CROUZET/claudine-cube/docs/building_pictures/IMG-20260719-WA0002.jpeg

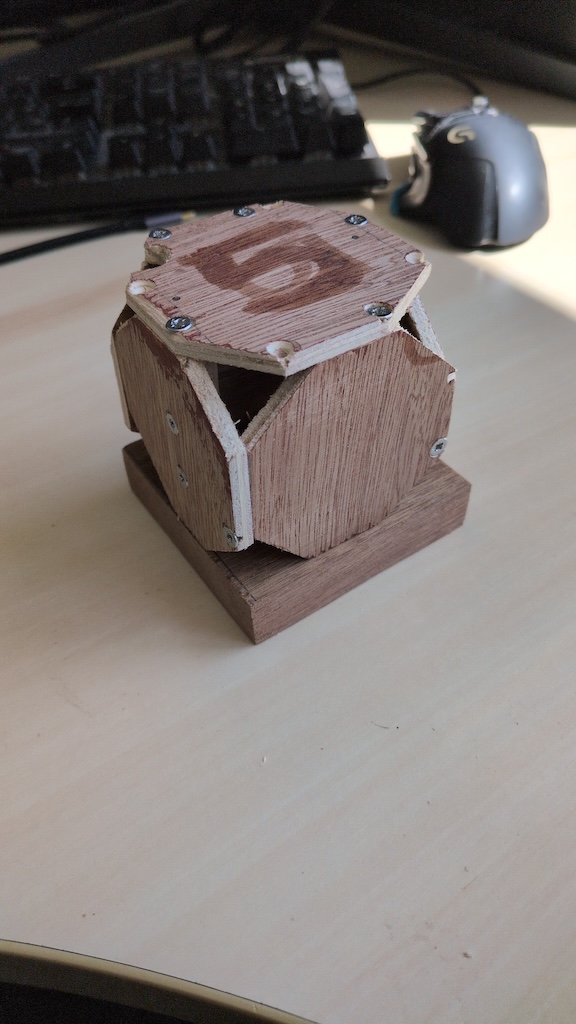
docs/building_pictures/IMG-20260719-WA0002.jpeg
