CROUZET/claudine-cube/docs/building_pictures/PXL_20260710_210710005.jpg

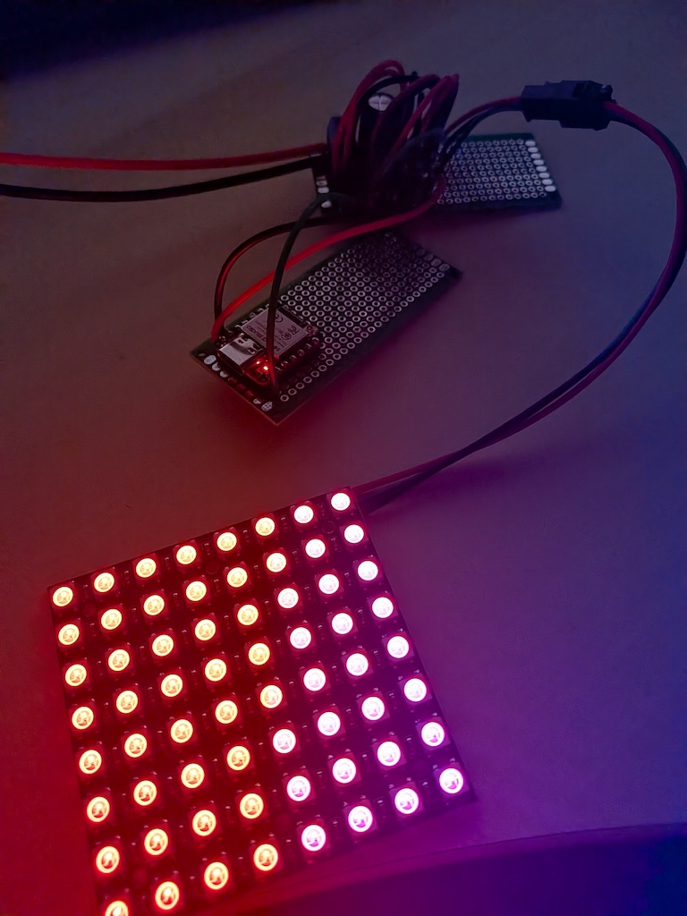
docs/building_pictures/PXL_20260710_210710005.jpg
