CROUZET/claudine-cube/docs/building_pictures/PXL_20260710_224117505.jpg

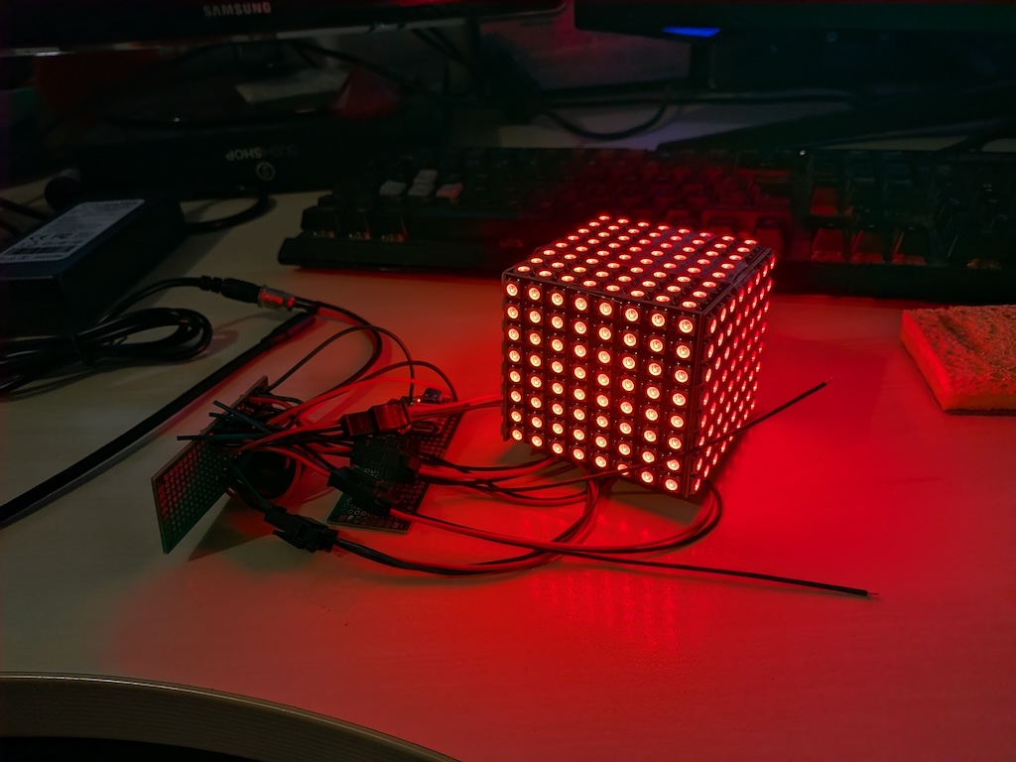
docs/building_pictures/PXL_20260710_224117505.jpg
