CROUZET/claudine-cube/docs/building_pictures/PXL_20260710_225541593.jpg

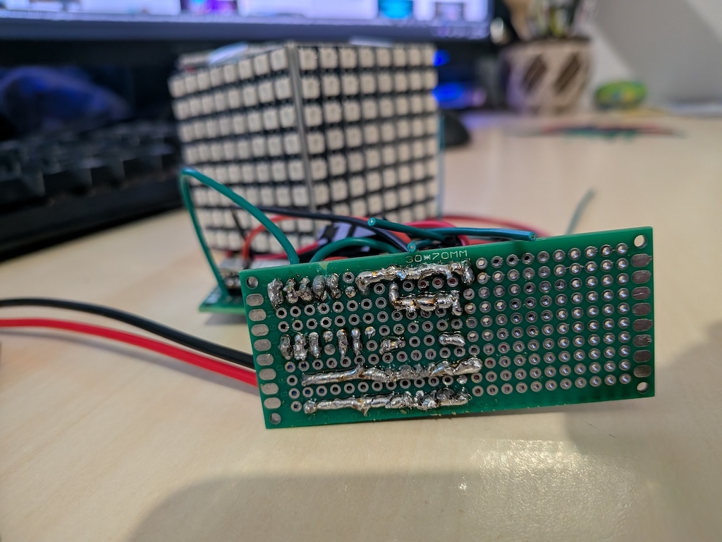
docs/building_pictures/PXL_20260710_225541593.jpg
