CROUZET/claudine-cube/docs/building_pictures/PXL_20260719_164101151.jpg

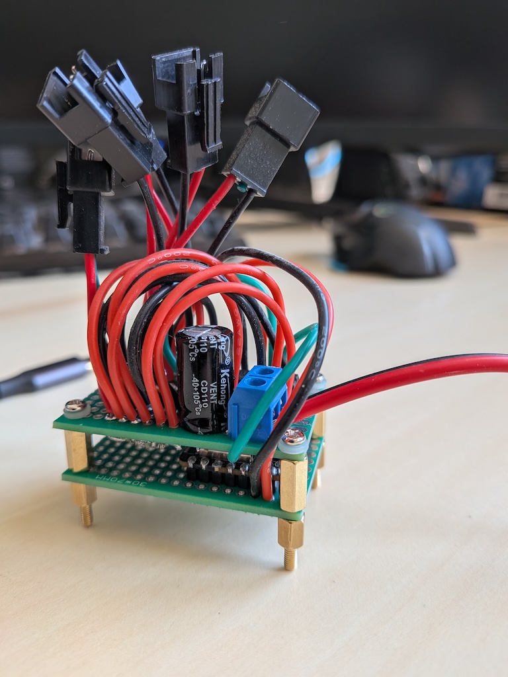
docs/building_pictures/PXL_20260719_164101151.jpg
