CROUZET/claudine-cube/docs/building_pictures/PXL_20260719_164112641.jpg

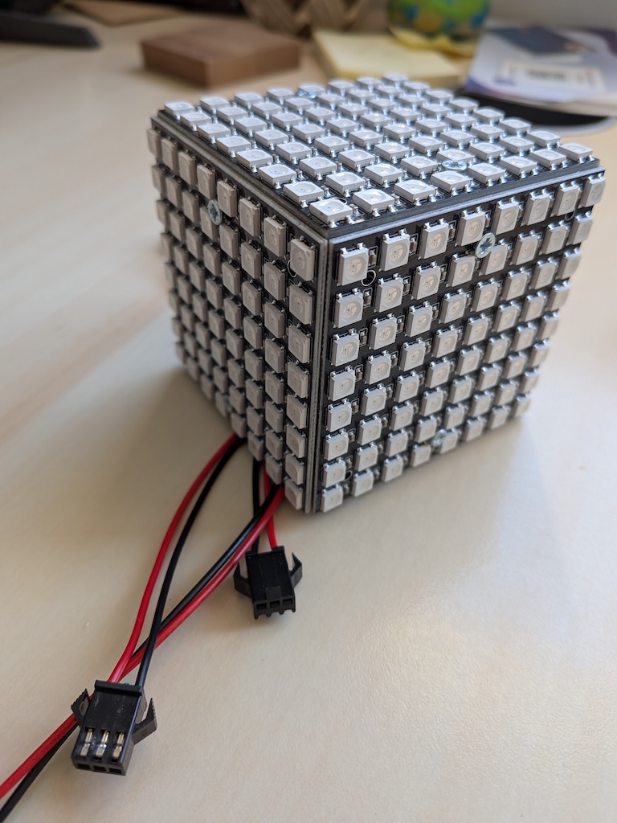
docs/building_pictures/PXL_20260719_164112641.jpg
