CROUZET/claudine-cube/docs/building_pictures/PXL_20260720_164136679.jpg

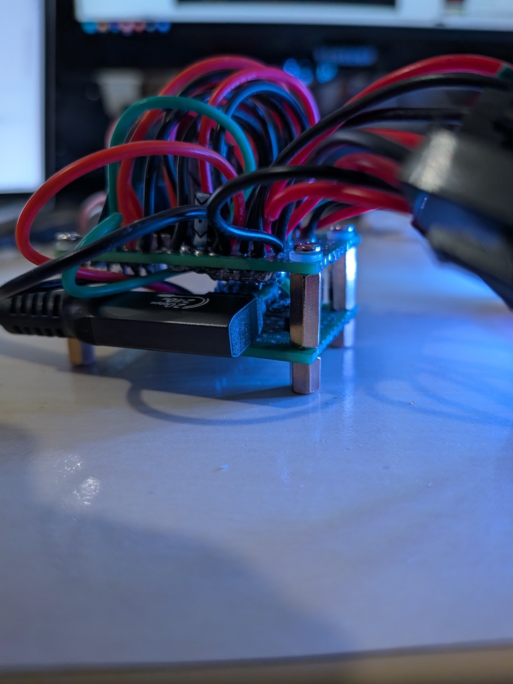
docs/building_pictures/PXL_20260720_164136679.jpg
