CROUZET/claudine-cube/docs/building_pictures/PXL_20260720_222201605.jpg

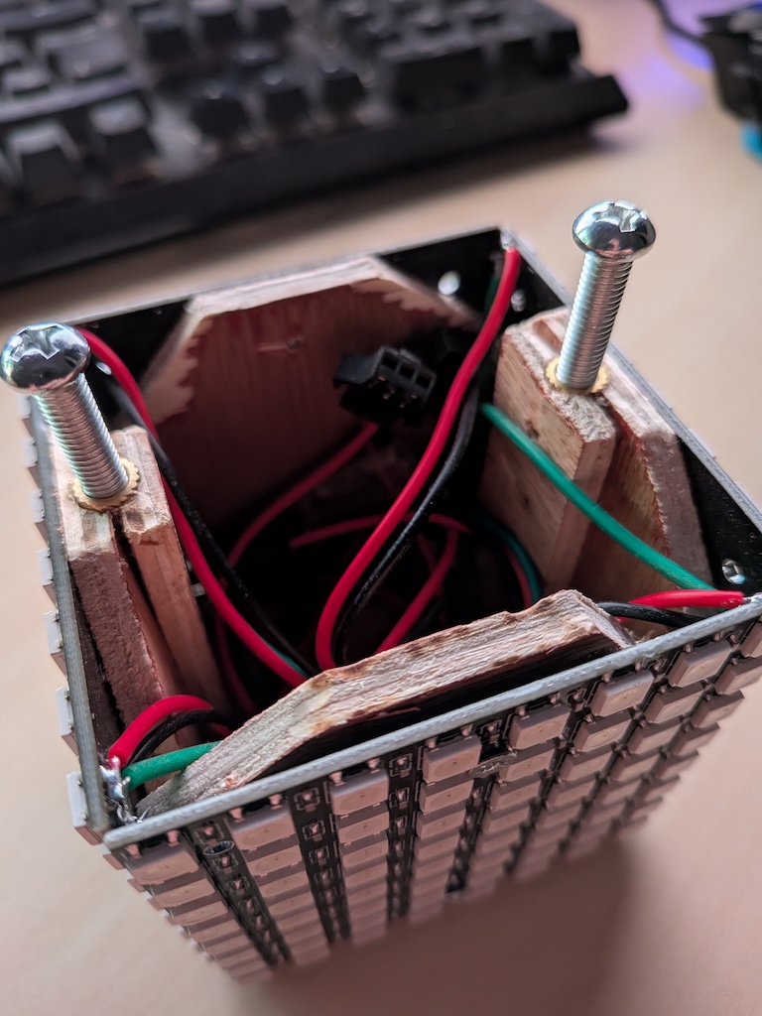
docs/building_pictures/PXL_20260720_222201605.jpg
