CROUZET/claudine-cube/docs/building_pictures/PXL_20260721_110255108.jpg

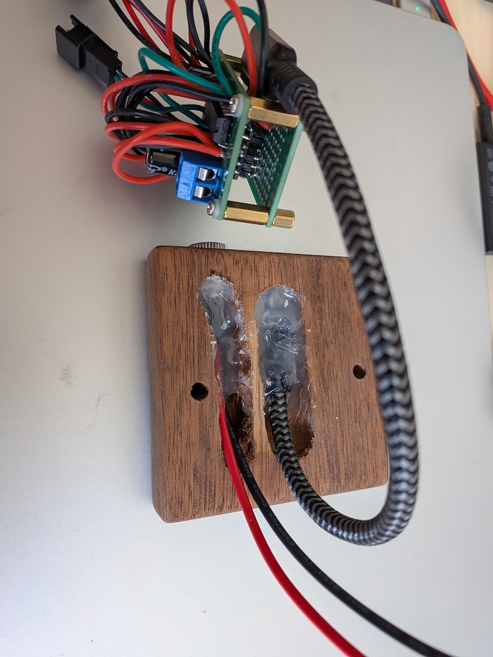
docs/building_pictures/PXL_20260721_110255108.jpg
