CROUZET/claudine-cube/docs/building_pictures/PXL_20260721_115038355.jpg

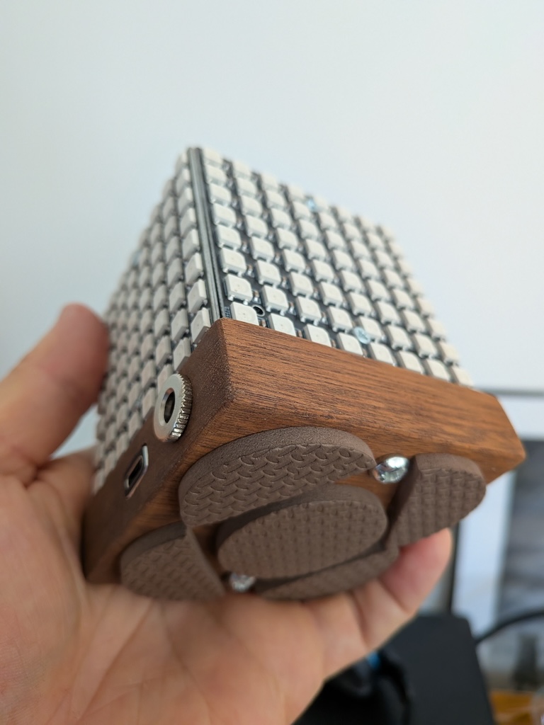
docs/building_pictures/PXL_20260721_115038355.jpg
