CROUZET/claudine-cube/docs/building_pictures/PXL_20260721_115052303.jpg

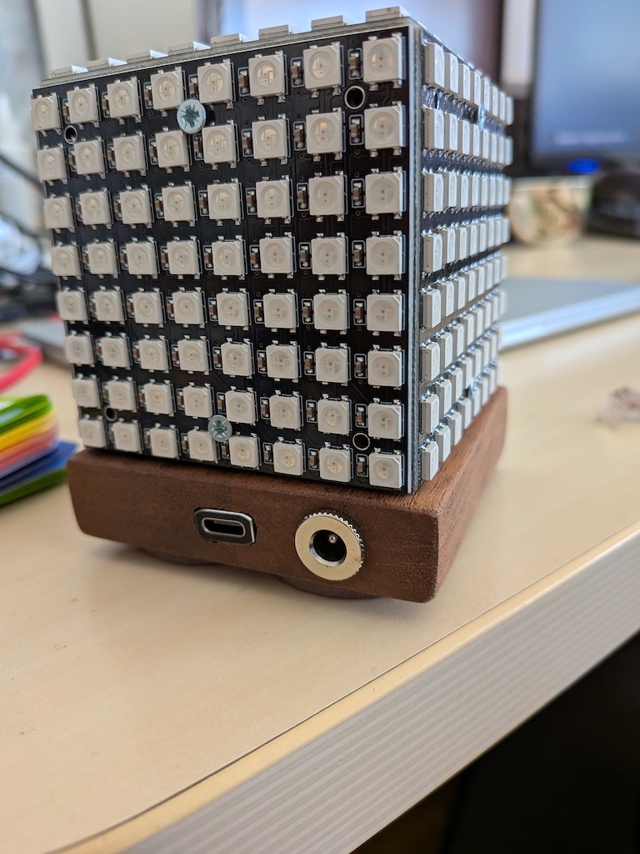
docs/building_pictures/PXL_20260721_115052303.jpg
