CROUZET/claudine-cube/sketch_firmware/testing/flashing_colors.ino

#include <FastLED.h>
#define DATA_PIN 1
#define NUM_LEDS 320
CRGB leds[NUM_LEDS];

void setup() {
  FastLED.addLeds<WS2812B, DATA_PIN, GRB>(leds, NUM_LEDS);
  FastLED.setBrightness(20); // ~0.08, faible
}

void loop() {
  fill_solid(leds, NUM_LEDS, CRGB::Red);
  FastLED.show();
  delay(500);
  fill_solid(leds, NUM_LEDS, CRGB::Green);
  FastLED.show();
  delay(500);
  fill_solid(leds, NUM_LEDS, CRGB::Blue);
  FastLED.show();
  delay(500);
}
