CROUZET/claudine-cube/(commit log)

2026-07-16 Import initial : Claudine Cube (portage cube LED de Claudine)
    Portage du panneau plat 16×16 de Claudine vers un cube 5 faces 8×8
    (320 WS2812B) piloté par un XIAO ESP32-S3.
    - Panel réécrit en adressage par face (face,x,y) via CubeMapping
    (plus de serpentine/FLIP) ; Settings 8×8×5=320.
    - Firmware sur Adafruit NeoPixel (backends FastLED non fiables sur
    XIAO S3 / IDF5) + Serial.setRxBufferSize(4096) — correctif de la
    corruption de trame liée au débordement du buffer RX pendant show().
    - Set d'animations "cube" par défaut : 16 hooks volumétriques, sans
    texte, chaque event distinguable par le mouvement (utilisateur
    légèrement daltonien).
    - AnimationManager en deux couches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
    [flashing_colors.ino, sketch_firmware.ino]
2026-07-17 Ajoute une variante user_prompt en sens inverse
    - user_prompt_2 : vague cyan ouverte centre du dessus → descente des faces
    (inverse de UserPrompt), tirée au sort avec l'originale à chaque event.
    - test_cube_preview joue désormais toutes les variantes d'un hook, pas
    seulement la première.
2026-07-17 Idle : comète chevron au bas du cube + fix durée du preview
    - system_idle : chevron « > » qui tourne au ras du bas des faces latérales
    (2 tours pleins garantis avant le fondu), suivi d'une comète de chevrons
    répétés en dégradé exponentiel (>>>>>).
    - test_cube_preview joue chaque anim pour sa propre DURATION si elle en
    déclare une (avant, system_idle était coupé à 2,5 s → arrêt vers la 3e face).
2026-07-17 Notification : 4 variantes en anneaux concentriques
    Remplace le clignotement plein cube par des combinaisons de cadres
    carrés concentriques (face_ring), tirées au sort par le manager :
    - Notification : d=0 + d=2 (cible)
    - Notification2 : d=2 + d=3 (cœur)
    - Notification3 : d=0 + d=1 (cadre extérieur)
    - Notification4 : d=1 + d=3 (négatif de Notification)
2026-07-17 Session start/end : vague arc-en-ciel diagonale (chaud/froid)
    session_start balaie tout le volume en diagonale (montée puis reflux
    jusqu'à extinction) en couleurs chaudes ; session_end reprend le même
    geste en couleurs froides. Plage de teintes portée par HUE0/HUE1,
    surchargée par la sous-classe SessionEnd.
2026-07-17 Harmonise MIN_DURATION explicite + fix test flaky
    Ajoute un MIN_DURATION explicite aux 4 hooks qui tombaient sur le défaut :
    post_tool (=DUR 0.5), pre_tool (0.6), subagent_start (0.6), stop (1.0,
    aligné sur stop_failure).
    test_manager_states : accepte toute variante de la famille user_prompt
    (le manager en tire une au hasard) — le test était flaky (~1 run/4)
    car il comparait la classe exacte.
2026-07-17 pre_tool : serpent jaune/ambré qui navigue à travers le cube
    Remplace la colonne rotative par un serpent de 2 px de large suivant un
    parcours à travers les 5 faces (avant↑ → dessus → arrière↓ → virage vers
    la droite → face droite → remonte → dessus → gauche↓ puis disparaît).
    Piste précalculée (rungs), longueur BODY=18, teinte orange/ambré tête→queue,
    trajet décalé d'1 px à gauche et virages 1 px après le milieu. MIN_DURATION
    couvre tout le parcours.
2026-07-17 post_tool : couronne de créneaux tournante + fix test manager
    Remplace le flash par une couronne crénelée (merlons de rempart) à la base
    des 4 faces latérales, qui tourne autour du cube, dans l'orange/ambré du
    serpent (pre_tool).
    test_manager_states : dérive les instants du scénario des MIN_DURATION
    réelles des overlays (au lieu de temps codés en dur) — le test était cassé
    depuis l'allongement de pre_tool (serpent, 2.2s).
2026-07-17 system_idle : anneau équatorial clignotant puis extinction douce
    Remplace la comète de chevrons par un anneau de 2 px à l'équateur (rangées
    3,4 des 4 faces latérales) qui clignote doucement (pulsation cosinus) puis
    s'éteint en fondu monotone. Le clignotement creste pile au début du fondu
    (raccord à dérivée nulle) → extinction sans sursaut.
2026-07-17 stop : dissolution jaune par paliers de teinte
    Remplace la respiration bleue par un cube moucheté de SHADES teintes de
    jaune (clair → foncé, réparties au hasard) qui s'éteignent teinte par teinte
    à intervalle régulier (STEP), du clair au foncé, jusqu'à extinction complète.
    MIN_DURATION couvre toute la dissolution.
2026-07-17 task_done : reprend le geste de task_new en jaune
    task_done devient une sous-classe de task_new (même clignotement concentrique
    alterné) avec COLOR jaune. task_new lit self.class::COLOR pour permettre la
    surcharge.
2026-07-17 pre_compact/post_compact : damier 2×2 clignotant (gris / jaune)
    pre_compact devient un damier de carrés 2×2 qui s'inverse à intervalle
    régulier sur les 5 faces (gris). post_compact reprend le même geste en jaune
    via une sous-classe ; pre_compact lit self.class::COLOR pour la surcharge.
2026-07-17 tests : supprime chain/solid (bug résolu), refait edge sur les 8 arêtes
    test_cube_chain.rb et test_cube_solid.rb servaient à diagnostiquer le bug
    d'affichage dont la cause racine (buffer RX USB-CDC) est trouvée : supprimés.
    test_cube_edge.rb : au lieu de la seule arête avant→dessus, allume les 8
    arêtes partagées (pixels 2→6 des 2 côtés, une couleur par arête) pour
    vérifier/caler la continuité de toutes en un coup.
    Docs (CLAUDE.md, README.md, docs/SOFTWARE.md) mises à jour.
2026-07-17 CLAUDE.md : les 8 arêtes validées sur matériel
    test_cube_edge.rb (8 arêtes, 2 côtés) confirme sur le cube que les 3 arêtes
    dessus↔latérales restantes (droite/arrière/gauche→dessus) sont continues et
    alignées telles quelles, aucun offset. Les effets qui les traversent
    (top_edge_px, serpent de pre_tool) sont corrects.
2026-07-17 bunny/user_prompt : lapins sautillant + surcharge CLAUDINE_BRIGHTNESS
    user_prompt (fond « thinking » du set bunny) : des lapins bleu clair
    sautillent en file autour de l'anneau, à des hauteurs de saut variées ;
    aux grands sauts la tête déborde sur le dessus le long de l'arête franchie.
    Boucle sans raccord.
    Settings::BRIGHTNESS devient surchargeable via CLAUDINE_BRIGHTNESS (défaut
    0,08 inchangé) pour tester des niveaux de luminosité sans rien committer.
    Docs (CLAUDE.md, README.md, docs/SOFTWARE.md) mises à jour : set bunny en
    cours + nouvelle variable d'environnement.
2026-07-17 bunny/pre_tool : lapins qui sautent puis dansent sur les 4 faces + dessus
    Overlay « avant outil » du set bunny : un lapin traverse l'avant (1) en
    sautant gauche→droite→gauche puis danse (léger déhanché écrasé) ; arrière (3)
    en miroir ; droite (2) + gauche (4) jouent la même animation inversée dans le
    temps (danse puis sauts), 4 en miroir de 2. Sur le dessus, 8 pixels près des
    coins clignotent en rythme. Blanc bleuté (charte : début = clair).
2026-07-17 bunny/post_tool : lapins qui dansent + coins du dessus, fondu (jaune)
    Overlay « après outil » du set bunny : un lapin sur chacune des 4 faces
    latérales se déhanche (danses staggerées), le dessus reprend les 8 pixels de
    coin clignotants de pre_tool, et tout s'éteint en fondu du début à la fin.
    Jaune (charte : fin = jaune).
2026-07-17 bunny/post_tool_fail + stop_failure : lapin rouge tremblant + gros X
    Échec (outil ou fin de tour) : un lapin tremble de colère sur les 4 faces
    latérales, en rouge, et un gros X rouge épais clignote sur le dessus.
    Animation partagée : stop_failure sous-classe post_tool_fail.
    Charte : erreur = rouge.
2026-07-17 bunny/stop : lapins qui courent puis s'arrêtent de face (jaune, fade out)
    Fin de tour (succès) : les lapins courent autour du cube (façon user_prompt,
    en jaune) puis s'arrêtent et se tournent de face (petit lapin frontal centré
    sur chaque face latérale) avant de s'éteindre en fondu. DURATION exposée pour
    que l'aperçu joue toute la séquence.
2026-07-17 bunny/notification : lapin qui salue + carotte + anneau tournant
    Notification du set bunny : avant/arrière → gros plan d'une tête de lapin qui
    fait coucou de la patte (jaune) ; droite/gauche → gros plan d'une carotte
    (corps rouge + fanes vertes) qui rebondit ; dessus → anneau extérieur (2 px)
    d'arcs jaunes qui tournent.
2026-07-17 bunny/subagent_start : lapins qui jaillissent puis tournent en sautant
    Démarrage d'un sous-agent : un petit lapin surgit du bas (effet ressort) sur
    chacune des 4 faces latérales, puis les 4 lapins font le tour du cube en
    sautant vers la droite, chacun à la place du suivant, 4 fois (tour complet).
    Bleu clair (charte : début = clair).
2026-07-17 bunny/subagent_stop : lapins qui tournent puis plongent au terrier (jaune)
    Fin d'un sous-agent : même geste que subagent_start mais en jaune et dans
    l'ordre inverse — les 4 lapins font d'abord le tour du cube en sautant
    (4 sauts vers la droite) puis plongent dans leur terrier (pop vers le bas).
    Sous-classe de SubagentStart ; subagent_start lit self.class::COLOR.
    Charte : fin = jaune.
2026-07-17 bunny/system_idle : lapins endormis + bulles de sommeil vers le dessus
    Veille : sur les 4 faces latérales, un lapin en « loaf » (oreilles repliées)
    dort en respirant, avec des bulles qui remontent en zigzag, débordent sur le
    dessus (top_edge_px) et convergent vers le haut, puis tout s'éteint en fondu.
    DURATION exposée pour que le manager coupe le cube à la fin.
2026-07-17 bunny/task_new : grand lapin de profil qui marche autour du cube (bleu clair)
    Nouvelle tâche : un lapin en gros plan (profil) marche tranquillement autour
    de l'anneau des 4 faces latérales, avec un cycle de pattes, traversant les
    arêtes sans couture. Bleu clair (charte : début = clair).
2026-07-17 bunny/task_done : le lapin fait demi-tour et laisse une crotte (jaune)
    Tâche terminée : le même lapin que task_new (gros plan de profil) marche en
    jaune sur un demi-tour du cube, en laissant un petit caca brun à sa position
    de départ (révélé quand il s'éloigne), puis tout s'éteint en fondu. Sous-classe
    de TaskNew. Charte : fin = jaune.
2026-07-17 bunny/pre_compact : 4 têtes qui fusionnent en un lapin (bleu clair)
    Avant compaction : une tête de lapin monte sur chacune des 4 faces latérales,
    passe sur le dessus, converge vers le centre, et les 4 fusionnent en un
    nouveau lapin (le profil de user_prompt) qui éclot. Bleu clair (charte :
    début = clair).
2026-07-17 bunny/post_compact : lapin fusionné jaune clignotant sur les 5 faces — set complet
    Après compaction : le lapin fusionné de pre_compact (profil de user_prompt)
    apparaît identique sur les 5 faces, clignote en jaune et s'estompe.
    Dernier hook du set bunny → set complet (16 hooks). Docs (CLAUDE.md,
    README.md, docs/SOFTWARE.md) mises à jour : bunny n'est plus « en cours ».
2026-07-21 test: ajoute test de limite d'affichage (320 LEDs, montée en luminosité)
    test/test_cube_stress.rb pousse toutes les LEDs par paliers de luminosité
    en contournant le scaling du Panel. Mesures consignées :
    - jack DC : blanc plein 100% OK, aucun artefact (~19 A théo. très pessimiste)
    - USB seul : brownout entre 20-25% de blanc plein
    Limite pratique = thermique, pas l'intégrité d'affichage. Résultats aussi
    notés dans docs/HARDWARE.md.
2026-07-21 docs: add design docs, consolidate ideas, translate everything to English
    New design docs (design exploration / frozen spec, nothing built yet):
    - docs/INTENTIONS.md: intention vocabulary (V1 frozen) decoupling the cube
    from Claude Code — animations target neutral states, a profile maps hooks.
    - docs/MARKETPLACE.md: vision for a shareable-animation marketplace (safe
    third-party code execution via WASM, creator journey).
    - docs/IDEAS.md: single index of evolutions, organized by maturity.
    Consolidation: the three divergent "Future ideas" sections (README, SOFTWARE.md)
    now point to IDEAS.md; obsolete/reversed items reclassified (edge calibration
    already done, simulator-first reversed, de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
2026-07-21 feat: implement the intention layer (source ↔ rendering decoupling)
    Animations are now indexed by *intention* (neutral state verbs), not by
    Claude Code hook. Implements docs/INTENTIONS.md (V1, now 16 intentions —
    added handle/handled so the task level is distinct from the tool level).
    - lib/intentions.rb: the vocabulary (kind + fallback per intention, mandatory
    core, cycle-safe fallback resolution).
    - lib/profiles/claude_code.rb: data table mapping the 16 hooks 1:1 to intentions.
    - AnimationManager: registry keyed by intention; resolves event → intention via
    the profile, walks the fallback chain when a set lacks one; the temporal role
    comes from Intentions.kind (ambient/pulse/bo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
2026-07-21 firmware: one-shot boot sweep (powered & ready indicator)
    On power-up the firmware plays a short, dim rainbow that fills along the LED
    chain then goes dark — a self-contained "cube is powered and ready" signal
    (also a quick R/G/B self-test), with no app required. It plays ONCE: no
    standby, no loop. Adalight frames take over immediately if the app is running
    (and the sweep never replays afterwards). Brightness capped (BOOT_VAL) to stay
    safe on USB-only power. Tunable via BOOT_FILL_MS / BOOT_HOLD_MS / BOOT_VAL.
    [sketch_firmware.ino]
2026-07-23 feat(admin): web control plane + live brightness (v1)
    Add a user-facing admin server as a third software component alongside
    the daemon and firmware. It is a control plane, not an event source: it
    never touches the render/animation path.
    - Config (lib/config.rb): single source of truth for live-tunable
    settings, persisted to ~/.claudine (JSON, user-level). Precedence
    ENV > file > Settings default. Atomic, merging writes. Safe-boot
    ceiling (0.25): higher values are volatile session boosts, never
    persisted, so a fresh (possibly USB-only) boot can't brown out on a
    stale high value.
    - AdminServer (lib/connectors/admin_server.rb): WEBrick on
    127.0.0.1:9293. GET / (page), GET /api/sta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
2026-07-23 feat(admin): integration on/off toggle (ClaudeCode)
    Second admin control, on the same Config-as-source-of-truth pattern.
    - Config: integrations map (name → bool, all on by default), persisted to
    ~/.claudine alongside brightness. integration_enabled? / set_integration.
    - ClaudeCode connector: reads the gate; when claude_code is off it still
    answers 204 (hooks never error) but drops the event instead of pushing,
    so the cube falls to idle. Gate on ingestion, never on the render path.
    - AdminServer: POST /api/integration { name, enabled }; /api/state now
    includes integrations.
    - Admin page: an "Intégrations" section (top) with a labeled switch;
    state shown by knob position + "activ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
2026-07-23 fix(admin): blank the cube when no source integration is enabled
    Turning ClaudeCode off only gated ingestion, so the manager kept looping
    the last animation until the 90 s idle timeout. Now the render loop treats
    "no active source" as "nothing to display":
    - Config#any_integration_enabled? — true iff at least one source is on.
    - Runner: when it is false, panel.clear + skip dispatch (and drain/discard
    any queued events); on the on→off transition it resets the manager so a
    later resume starts blank rather than mid-loop.
    - AnimationManager#reset — clears current/background/overlay/pending/idle.
    - Tests: any_integration_enabled? (test_config), reset (test_manager_states).
    - Docs: CLAU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
2026-07-23 feat(admin): theme selector — hot-swap the animation set
    Third and last planned control, same Config-observed-by-Runner pattern.
    - Config: theme key (precedence CLAUDINE_ANIMATION_SET > ~/.claudine >
    'cube'), persisted; exposed in to_state.
    - AnimationManager: self.available_sets (scans lib/animations/ subdirs) and
    switch_set(name) — reloads the registry, swaps @set, resets state
    (unknown set → logged no-op).
    - Runner: switches the manager when config.theme changes (only on change,
    not every frame).
    - AdminServer: POST /api/theme { theme } (rejects unknown via
    available_sets); /api/state now includes theme + themes.
    - claudine.rb: boot the manager with the persisted theme, g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
2026-07-23 refactor(settings): centralize config constants in config/settings.rb
    Pull scattered configuration constants into Settings, the single home for
    tunables. Fixes a latent duplication: Settings::CLAUDE_CODE_PORT existed
    but the connector hard-coded its own 9292 and never used it.
    - Settings: add LOCAL_HOST, ADMIN_PORT, DEFAULT_ANIMATION_SET,
    BRIGHTNESS_BOOST_CEILING (CLAUDE_CODE_PORT was already there).
    - ClaudeCode / AdminServer: use Settings for port + host (drop their own
    DEFAULT_PORT/HOST); ClaudeCode now actually honors CLAUDE_CODE_PORT.
    - Config: BOOST_CEILING is now an alias of Settings::BRIGHTNESS_BOOST_CEILING;
    drop Config::DEFAULT_THEME in favor of Settings::DEFAULT_ANIMATION_S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
2026-07-23 feat(admin): read-only status panel
    Adds a live "État" dashboard to the admin page: current state, animation,
    seconds since the last event, uptime — so you can tell at a glance what the
    cube (often across the room) is doing.
    Mirror of the config-observe pattern, in reverse: the Runner *publishes* a
    frozen snapshot into a shared Status each frame; the AdminServer reads it.
    Both are single atomic reference ops under the GIL — no lock, no queue.
    - lib/status.rb: thread-safe snapshot holder (publish / current).
    - AnimationManager#status(now): {set, animation, state, last_event_ago};
    state is working/overlay/idle/showing/blank.
    - Runner: publishes each frame (adds uptime_s, fps, source_a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
2026-07-23 feat(admin): trigger buttons — play any intention on demand
    A 4×4 grid on the admin page fires any of the 16 vocabulary intentions
    live — to preview a theme or demo without running Claude Code.
    - AnimationManager#resolve: an event whose type is itself a known
    intention now resolves directly (bypassing the profile). Lets any
    source — here the admin — speak intentions. Safe: the only profile key
    that is also an intention name is `stop`, which maps to itself.
    - AdminServer: POST /api/trigger { intention } pushes an intention event
    onto the bus (400 unknown, 503 if no bus); /api/state now also lists the
    intention vocabulary. Takes the bus (optional) from claudine.rb.
    - Admin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
2026-07-23 fix(admin): trigger plays once; translate the admin page to English
    - Trigger animations now play a single time. The trigger event carries
    once:true; AnimationManager plays it as a one-shot overlay whatever its
    kind — even an ambient like `think` no longer becomes a looping
    background — then reverts to the working loop, or blanks if none.
    (Adds @oneshot; the overlay-end path blanks a one-shot with no bg.)
    - Admin page fully translated to English (project convention): section
    titles, switch on/off text, status labels, brightness warning/foot,
    trigger hint, aria-labels, offline/send-failed messages.
    - Tests: one-shot behavior (test_manager_states), trigger payload once:true
    (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
2026-07-23 fix(admin): clear the panel when a one-shot trigger ends
    The one-shot end path set @current = nil but never blanked the buffer, so
    the Runner kept pushing the animation's last frame — the cube stayed lit.
    Call panel.clear there (like the idle-off path already does).
    - Test: a spy panel confirms clear is called at the one-shot end
    (test_manager_states).
2026-07-23 test: split automated tests (minitest) from on-cube diagnostics
    The test/ dir conflated two different things: hardware-free logic tests and
    manual visual/diagnostic tools that need the real cube. Separate them.
    - Automated tests → minitest under test/, run with `bundle exec rake test`:
    config_test, animation_manager_test (ex test_manager_states),
    animations_smoke_test (ex test_cube_animations, now asserts both sets render
    cleanly), admin_server_test, claude_code_gate_test + a shared test_helper
    (stub panels, free_port, quiet logs). Same coverage, standard runner.
    - On-cube diagnostics → diagnostics/ (git mv, dropped the test_ prefix):
    cube_faces, cube_edge, cube_preview, cube_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
2026-07-23 build(rake): add a diagnostics: namespace to run the on-cube utilities
    Now that there's a Rakefile, expose the hardware diagnostics as rake tasks
    for a uniform, discoverable entry point (`bundle exec rake -T`):
    - diagnostics:faces / :edge / :preview / :stress — each shells out to its
    script under diagnostics/. `default` stays :test only (diagnostics need
    the cube). preview takes INTENTIONS="think handled" to filter.
    - Docs (README, CLAUDE.md, SOFTWARE.md) present the rake tasks as the
    primary interface, with the direct `ruby diagnostics/*.rb` as fallback.
2026-07-23 style: adopt RuboCop (config, CI lint, autocorrections, de-alignment)
    Introduce RuboCop as a linter and apply a first style pass. One commit as
    the changes are interleaved across files; the next style tweaks will be
    separate.
    - Gemfile: rubocop + rubocop-minitest/-rake/-performance (test group,
    require: false), pinned ~> major.minor.patch.
    - .rubocop.yml: tailored config (rules sorted alphabetically) — keep the
    high-value Lint/Performance cops, but don't fight the codebase's
    deliberate choices: short domain names (x/y/r/g/b/t), dense animation
    render math (relaxed Metrics), and no cosmetic space-alignment
    (Layout/ExtraSpacing: AllowForAlignment: false) EXCEPT the animation
    fil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
2026-07-24 Admin trigger: play while sources off + optional duration
    A manual admin trigger is a control-plane action, not a source event, so
    it now plays its one-shot even when every integration is disabled (the
    Runner's per-frame `drive` lets `once:`-tagged events through, then
    re-blanks). POST /api/trigger also accepts an optional `duration` (clamped
    to MAX_TRIGGER_DURATION) that overrides how long the one-shot stays up.
    Trigger buttons in the admin page are no longer disabled while the cube is
    off, and gain a Duration field (blank = animation's natural length).
    Adds test/runner_test.rb (drive gating) plus duration cases in the manager
    and admin-server tests.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
